hardenedlinux/cheap-pcb/README

## Cheap PCB: Better understanding the current status of hardware supply chain

We did this experimental for fun and profit( better assessment for hardware supply chain security). Read the [full story](https://github.com/hardenedlinux/cheap-pcb/blob/main/cheap-pcb-story.md).
