hardenedlinux/cheap-pcb/stm32-io-extend/v6/gerber/stm32-io-extend-all-pos.png

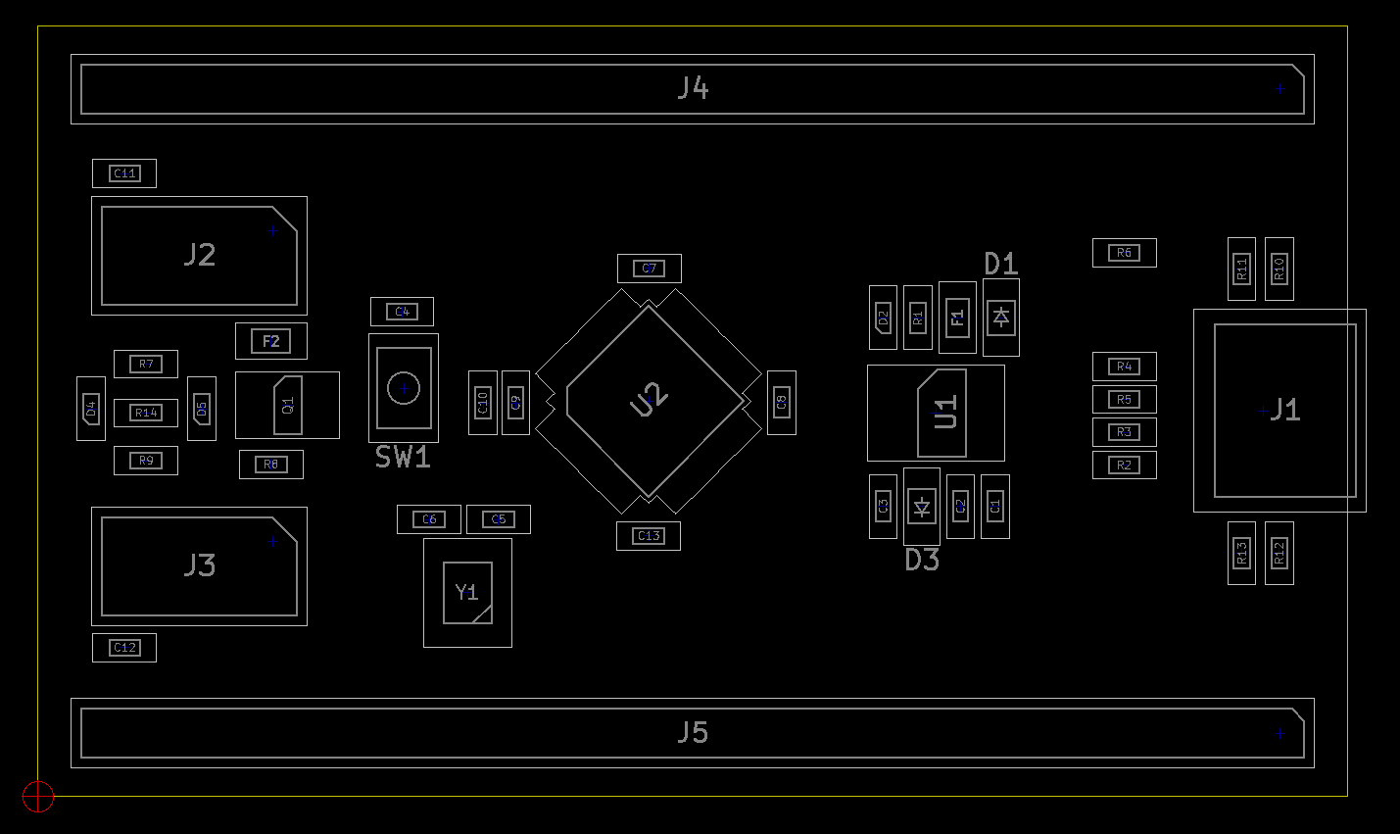
stm32-io-extend/v6/gerber/stm32-io-extend-all-pos.png
