hardenedlinux/cheap-pcb/(threads)

Thread 1 (2021-02-19):

Are these "series capacitors"?

jangid, 2021-02-19:
> For the input and output of the voltage regulator chip, two series capacitors are required to store energy and filter out clutter.

Why are you calling them "series capacitors"? Is this an error or perhaps I have misunderstood something.

cheapcb, 2021-02-19:
Nice catch! Thanks.

Closed 2021-02-19.
