hardenedlinux/cheap-pcb/(list of files, drawings)

Other design files:
stm32-io-extend/v1/stm32-io-extend.dsn
stm32-io-extend/v2/stm32-io-extend.dsn
stm32-io-extend/v3/stm32-io-extend.dsn
stm32-io-extend/v4/stm32-io-extend.dsn
stm32-io-extend/v5/stm32-io-extend.dsn
stm32-io-extend/v6/stm32-io-extend.dsn
