hardenedlinux/cheap-pcb/stm32-io-extend/v4/stm32-io-extend.kicad_pcb

## KiCad design stm32-io-extend/v4/stm32-io-extend.kicad_pcb (2021-02-10, an earlier design)

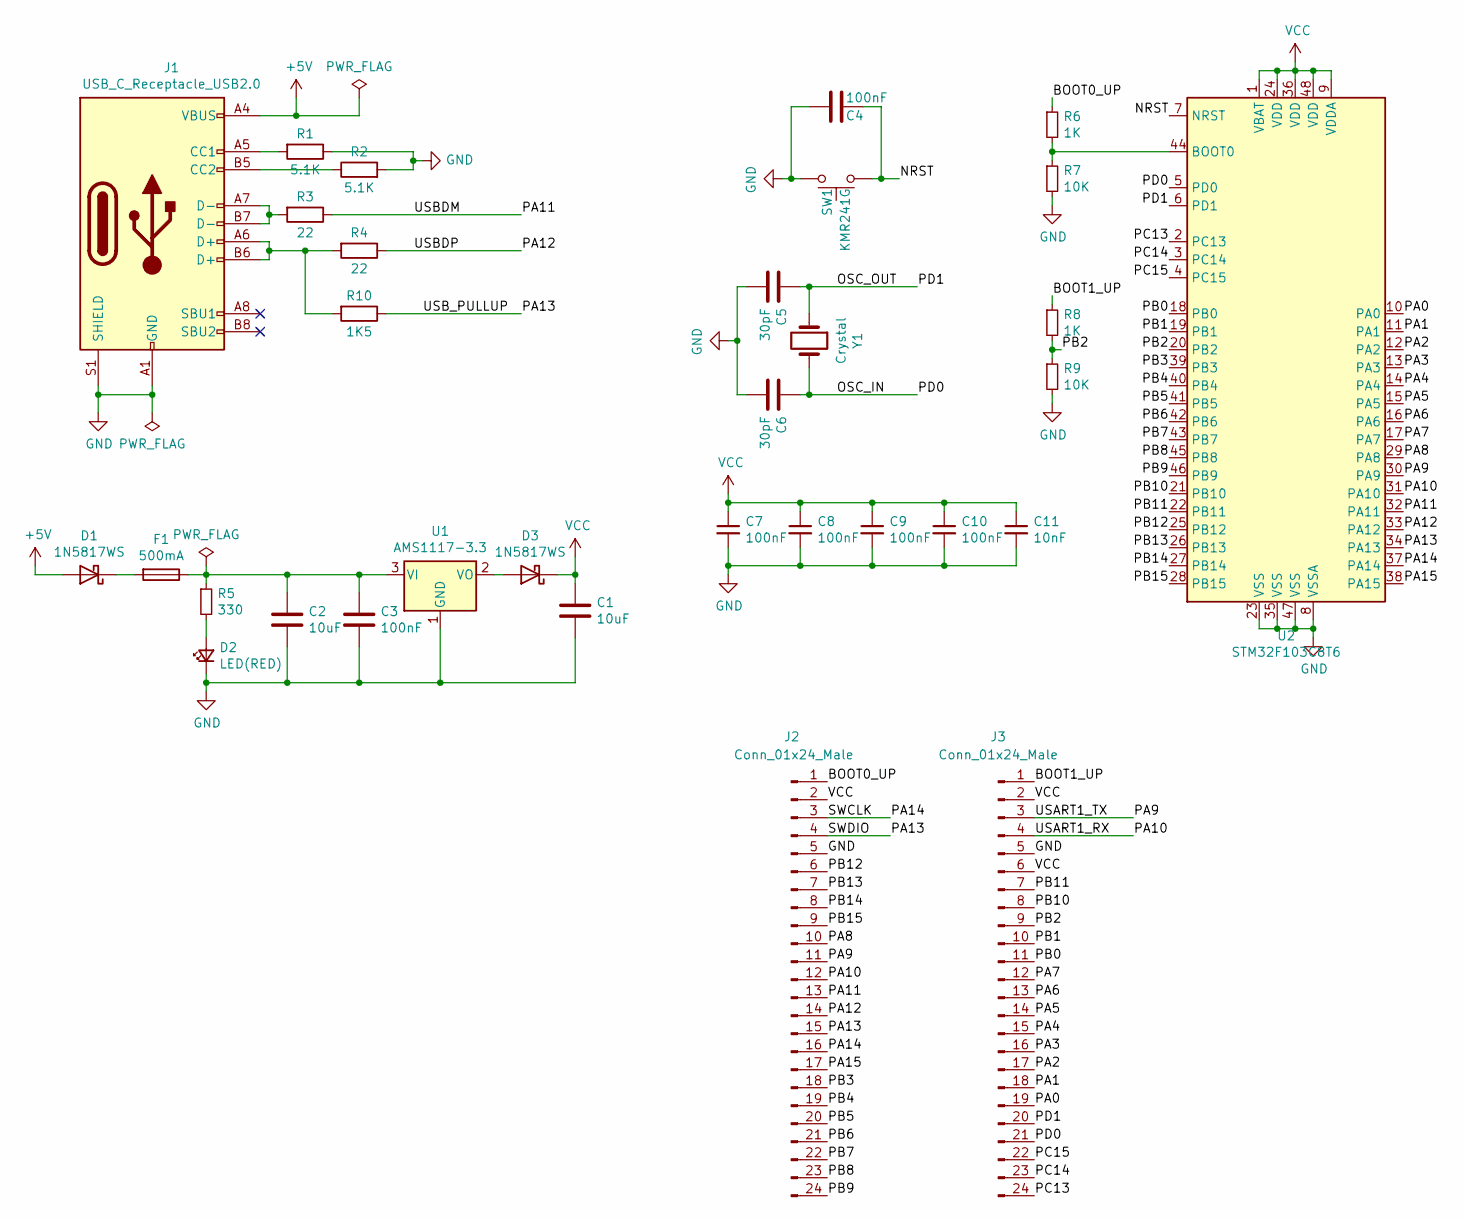
[picture p18: schematic stm32-io-extend.sch]

Parts:
C1, C2: 10uF; C_0603_1608Metric_Pad1.08x0.95mm_HandSolder
C3, C4, C7, C8, C9, C10: 100nF; C_0603_1608Metric_Pad1.08x0.95mm_HandSolder
C5, C6: 30pF; C_0603_1608Metric_Pad1.08x0.95mm_HandSolder
C11: 10nF; C_0603_1608Metric_Pad1.08x0.95mm_HandSolder
D1, D3: 1N5817WS; D_SOD-323_HandSoldering
D2: LED(RED); LED_0603_1608Metric_Pad1.05x0.95mm_HandSolder
F1: 500mA; Fuse_0805_2012Metric_Pad1.15x1.40mm_HandSolder
J1: USB_C_Receptacle_USB2.0; USB_C_Receptacle_Palconn_UTC16-G
J2, J3: Conn_01x24_Male; PinHeader_1x24_P2.54mm_Vertical
R1, R2: 5.1K; R_0603_1608Metric_Pad0.98x0.95mm_HandSolder
R3, R4: 22; R_0603_1608Metric_Pad0.98x0.95mm_HandSolder
R5: 330; R_0603_1608Metric_Pad0.98x0.95mm_HandSolder
R6, R8: 1K; R_0603_1608Metric_Pad0.98x0.95mm_HandSolder
R7, R9: 10K; R_0603_1608Metric_Pad0.98x0.95mm_HandSolder
R10: 1K5; R_0603_1608Metric_Pad0.98x0.95mm_HandSolder
SW1: KMR241G; SW_Push_1P1T-SH_NO_CK_KMR2xxG
U1: AMS1117-3.3; SOT-89-3_Handsoldering
U2: STM32F103C8T6; LQFP-48_7x7mm_P0.5mm
Y1: Crystal; Crystal_SMD_HC49-SD_HandSoldering

Connections:
+5V: D1.2 (A), J1.A4 (VBUS), J1.A9 (VBUS), J1.B4 (VBUS), J1.B9 (VBUS)
/BOOT0_UP: J2.1, R6.1
/BOOT1_UP: J3.1, R8.1
/NRST: C4.1, SW1.1, U2.7 (NRST)
/OSC_IN: C6.1, J3.21, U2.5 (PD0), Y1.2
/OSC_OUT: C5.1, J3.20, U2.6 (PD1), Y1.1
/PA0: J3.19, U2.10 (PA0)
/PA1: J3.18, U2.11 (PA1)
/PA2: J3.17, U2.12 (PA2)
/PA3: J3.16, U2.13 (PA3)
/PA4: J3.15, U2.14 (PA4)
/PA5: J3.14, U2.15 (PA5)
/PA6: J3.13, U2.16 (PA6)
/PA7: J3.12, U2.17 (PA7)
/PA8: J2.10, U2.29 (PA8)
/PA9: J2.11, J3.3, U2.30 (PA9)
/PA10: J2.12, J3.4, U2.31 (PA10)
/PA11: J2.13, R3.1, U2.32 (PA11)
/PA12: J2.14, R4.1, U2.33 (PA12)
/PA13: J2.4, J2.15, R10.1, U2.34 (PA13)
/PA14: J2.3, J2.16, U2.37 (PA14)
/PA15: J2.17, U2.38 (PA15)
/PB0: J3.11, U2.18 (PB0)
/PB1: J3.10, U2.19 (PB1)
/PB2: J3.9, R8.2, R9.1, U2.20 (PB2)
/PB3: J2.18, U2.39 (PB3)
/PB4: J2.19, U2.40 (PB4)
/PB5: J2.20, U2.41 (PB5)
/PB6: J2.21, U2.42 (PB6)
/PB7: J2.22, U2.43 (PB7)
/PB8: J2.23, U2.45 (PB8)
/PB9: J2.24, U2.46 (PB9)
/PB10: J3.8, U2.21 (PB10)
/PB11: J3.7, U2.22 (PB11)
/PB12: J2.6, U2.25 (PB12)
/PB13: J2.7, U2.26 (PB13)
/PB14: J2.8, U2.27 (PB14)
/PB15: J2.9, U2.28 (PB15)
/PC13: J3.24, U2.2 (PC13)
/PC14: J3.23, U2.3 (PC14)
/PC15: J3.22, U2.4 (PC15)
GND: C1.2, C2.2, C3.2, C4.2, C5.2, C6.2, C7.2, C8.2, C9.2, C10.2, C11.2, D2.1 (K), J1.A1 (GND), J1.A12 (GND), J1.B1 (GND), J1.B12 (GND), J1.S1 (SHIELD), J2.5, J3.5, R1.1, R2.2, R7.2, R9.2, SW1.2, U1.1 (GND), U2.8 (VSSA), U2.23 (VSS), U2.35 (VSS), U2.47 (VSS)
unnamed: C2.1, C3.1, F1.1, R5.1, U1.3 (VI)
unnamed: D1.1 (K), F1.2
unnamed: D2.2 (A), R5.2
unnamed: D3.2 (A), U1.2 (VO)
unnamed: J1.A5 (CC1), R1.2
unnamed: J1.A6 (D+), J1.B6 (D+), R4.2, R10.2
unnamed: J1.A7 (D-), J1.B7 (D-), R3.2
unnamed: J1.B5 (CC2), R2.1
unnamed: R6.2, R7.1, U2.44 (BOOT0)
VCC: C1.1, C7.1, C8.1, C9.1, C10.1, C11.1, D3.1 (K), J2.2, J3.2, J3.6, U2.1 (VBAT), U2.9 (VDDA), U2.24 (VDD), U2.36 (VDD), U2.48 (VDD)

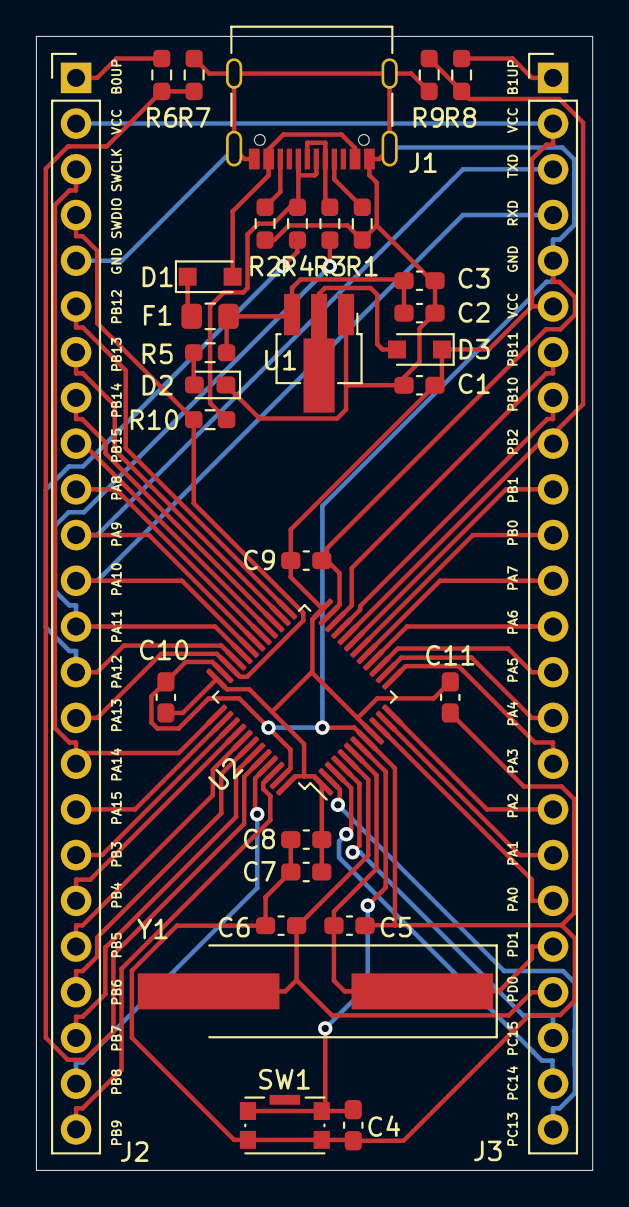
[picture p19: board stm32-io-extend/v4/stm32-io-extend.kicad_pcb from above]

Board: 2 copper layers, 30.9 x 63.0 mm, 32 parts (0 on the bottom side), 52 nets.
