hardenedlinux/cheap-pcb/stm32-io-extend/v1/stm32-io-extend.kicad_pcb

## KiCad design stm32-io-extend/v1/stm32-io-extend.kicad_pcb (2021-02-10, an earlier design)

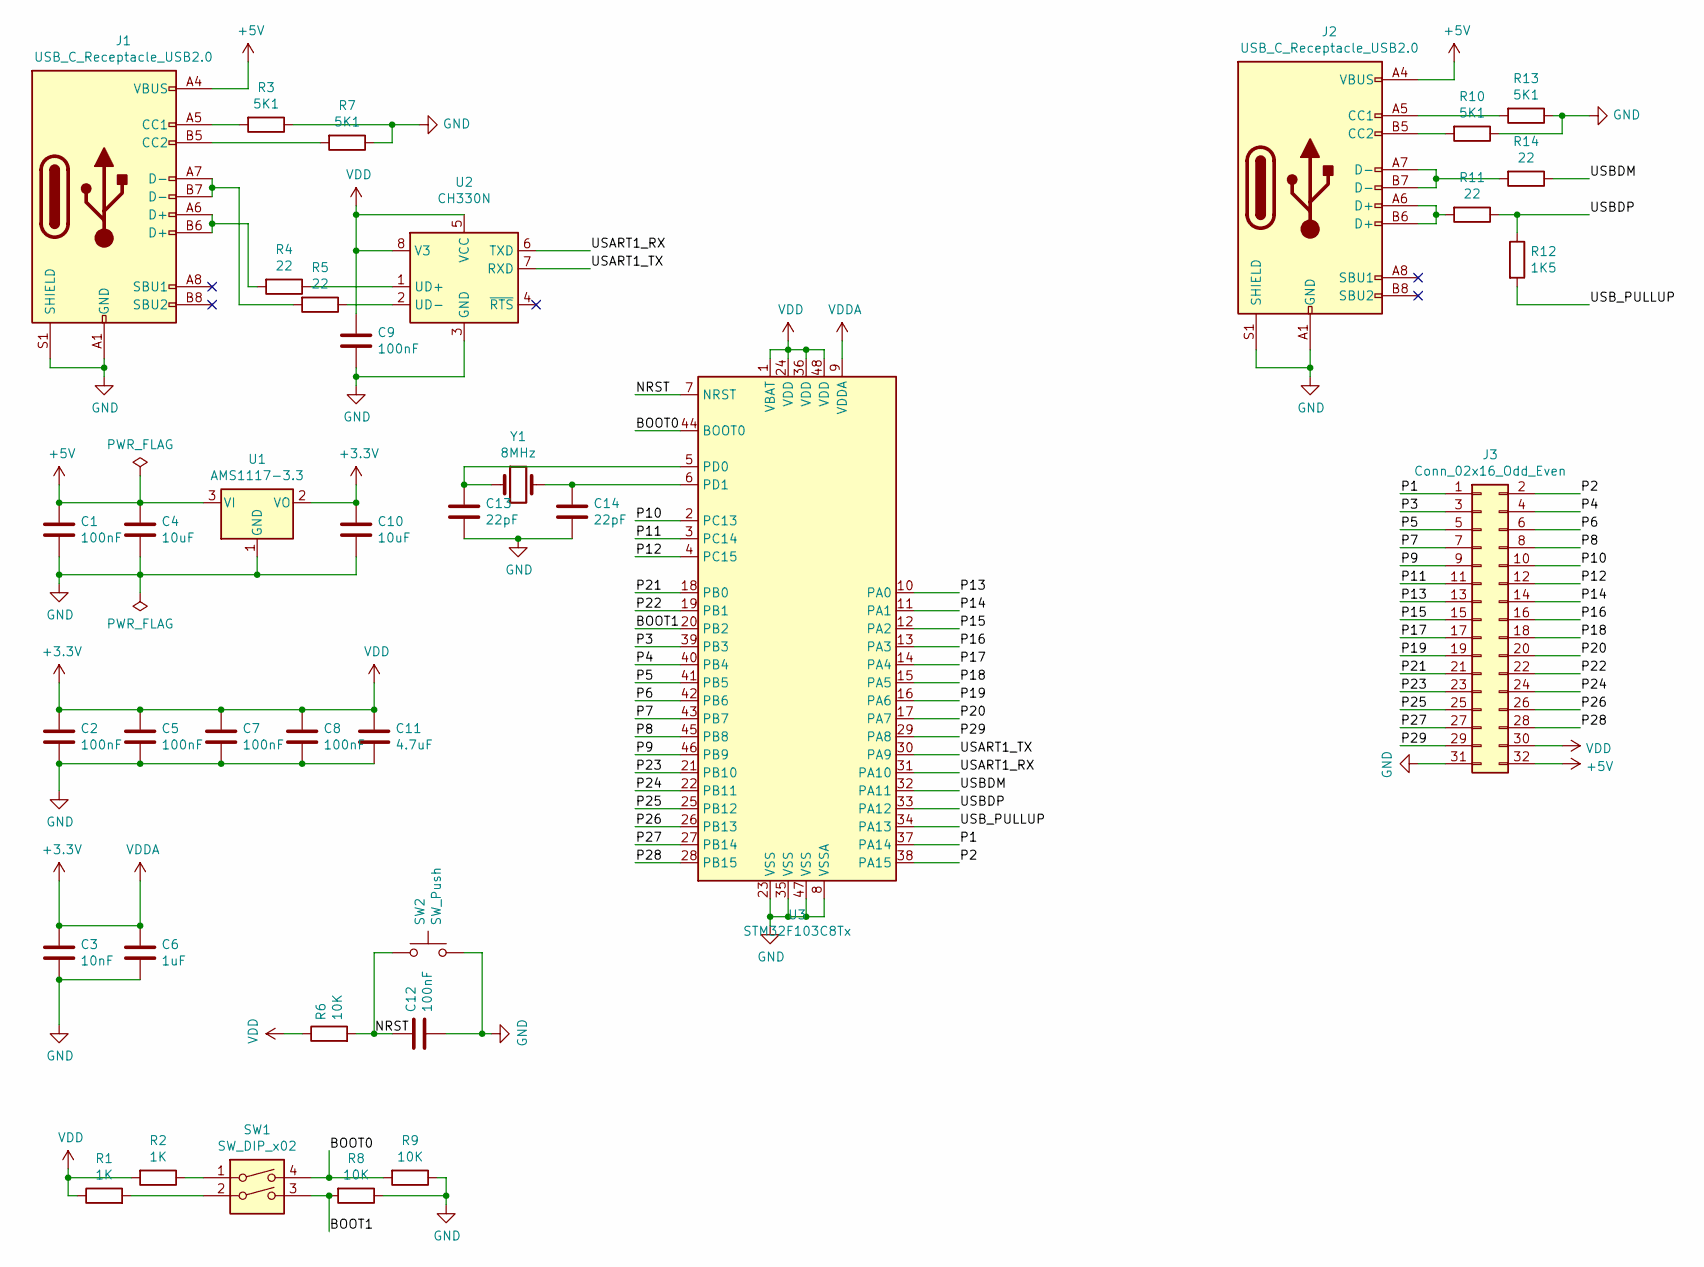
[picture p20: schematic stm32-io-extend.sch]

Parts:
C1, C2, C5, C7, C8, C9, C12: 100nF; C_0201_0603Metric
C3: 10nF; C_0201_0603Metric
C4, C10: 10uF; C_0603_1608Metric
C6: 1uF; C_0201_0603Metric
C11: 4.7uF; C_0603_1608Metric
C13, C14: 22pF; C_0201_0603Metric
J1, J2: USB_C_Receptacle_USB2.0; USB_C_Receptacle_Palconn_UTC16-G
J3: Conn_02x16_Odd_Even; PinSocket_2x16_P2.54mm_Vertical
R1, R2: 1K; R_0201_0603Metric
R3, R7, R10, R13: 5K1; R_0201_0603Metric
R4, R5, R11, R14: 22; R_0201_0603Metric
R6, R8, R9: 10K; R_0201_0603Metric
R12: 1K5; R_0201_0603Metric
SW1: SW_DIP_x02; SW_DIP_SPSTx02_Slide_6.7x6.64mm_W7.62mm_P2.54mm_LowProfile
SW2: SW_Push; SW_PUSH_6mm
U1: AMS1117-3.3; SOT-223
U2: CH330N; SOIC-8_3.9x4.9mm_P1.27mm
U3: STM32F103C8Tx; LQFP-48_7x7mm_P0.5mm
Y1: 8MHz; Crystal_HC49-U_Vertical

Connections:
+3V3: C2.1, C3.1, C5.1, C6.1, C7.1, C8.1, C9.1, C10.1, C11.1, J3.30, R1.1, R2.2, R6.1, U1.2 (VO), U2.5 (VCC), U2.8 (V3), U3.1 (VBAT), U3.9 (VDDA), U3.24 (VDD), U3.36 (VDD), U3.48 (VDD)
+5V: C1.1, C4.1, J1.A4 (VBUS), J1.A9 (VBUS), J1.B4 (VBUS), J1.B9 (VBUS), J2.A4 (VBUS), J2.A9 (VBUS), J2.B4 (VBUS), J2.B9 (VBUS), J3.32, U1.3 (VI)
/BOOT0: R9.2, SW1.4, U3.44 (BOOT0)
/BOOT1: R8.2, SW1.3, U3.20 (PB2)
/NRST: C12.1, R6.2, SW2.1, U3.7 (NRST)
/P1: J3.1, U3.37 (PA14)
/P2: J3.2, U3.38 (PA15)
/P3: J3.3, U3.39 (PB3)
/P4: J3.4, U3.40 (PB4)
/P5: J3.5, U3.41 (PB5)
/P6: J3.6, U3.42 (PB6)
/P7: J3.7, U3.43 (PB7)
/P8: J3.8, U3.45 (PB8)
/P9: J3.9, U3.46 (PB9)
/P10: J3.10, U3.2 (PC13)
/P11: J3.11, U3.3 (PC14)
/P12: J3.12, U3.4 (PC15)
/P13: J3.13, U3.10 (PA0)
/P14: J3.14, U3.11 (PA1)
/P15: J3.15, U3.12 (PA2)
/P16: J3.16, U3.13 (PA3)
/P17: J3.17, U3.14 (PA4)
/P18: J3.18, U3.15 (PA5)
/P19: J3.19, U3.16 (PA6)
/P20: J3.20, U3.17 (PA7)
/P21: J3.21, U3.18 (PB0)
/P22: J3.22, U3.19 (PB1)
/P23: J3.23, U3.21 (PB10)
/P24: J3.24, U3.22 (PB11)
/P25: J3.25, U3.25 (PB12)
/P26: J3.26, U3.26 (PB13)
/P27: J3.27, U3.27 (PB14)
/P28: J3.28, U3.28 (PB15)
/P29: J3.29, U3.29 (PA8)
/USART1_RX: U2.6 (TXD), U3.31 (PA10)
/USART1_TX: U2.7 (RXD), U3.30 (PA9)
/USBDM: R14.1, U3.32 (PA11)
/USBDP: R11.1, R12.1, U3.33 (PA12)
/USB_PULLUP: R12.2, U3.34 (PA13)
GND: C1.2, C2.2, C3.2, C4.2, C5.2, C6.2, C7.2, C8.2, C9.2, C10.2, C11.2, C12.2, C13.2, C14.2, J1.A1 (GND), J1.A12 (GND), J1.B1 (GND), J1.B12 (GND), J1.S1 (SHIELD), J2.A1 (GND), J2.A12 (GND), J2.B1 (GND), J2.B12 (GND), J2.S1 (SHIELD), J3.31, R3.1, R7.1, R8.1, R9.1, R10.1, R13.1, SW2.2, U1.1 (GND), U2.3 (GND), U3.8 (VSSA), U3.23 (VSS), U3.35 (VSS), U3.47 (VSS)
unnamed: C13.1, U3.5 (PD0), Y1.1
unnamed: C14.1, U3.6 (PD1), Y1.2
unnamed: J1.A5 (CC1), R3.2
unnamed: J1.A6 (D+), J1.B6 (D+), R4.2
unnamed: J1.A7 (D-), J1.B7 (D-), R5.2
unnamed: J1.B5 (CC2), R7.2
unnamed: J2.A5 (CC1), R13.2
unnamed: J2.A6 (D+), J2.B6 (D+), R11.2
unnamed: J2.A7 (D-), J2.B7 (D-), R14.2
unnamed: J2.B5 (CC2), R10.2
unnamed: R1.2, SW1.2
unnamed: R2.1, SW1.1
unnamed: R4.1, U2.1 (UD+)
unnamed: R5.1, U2.2 (UD-)

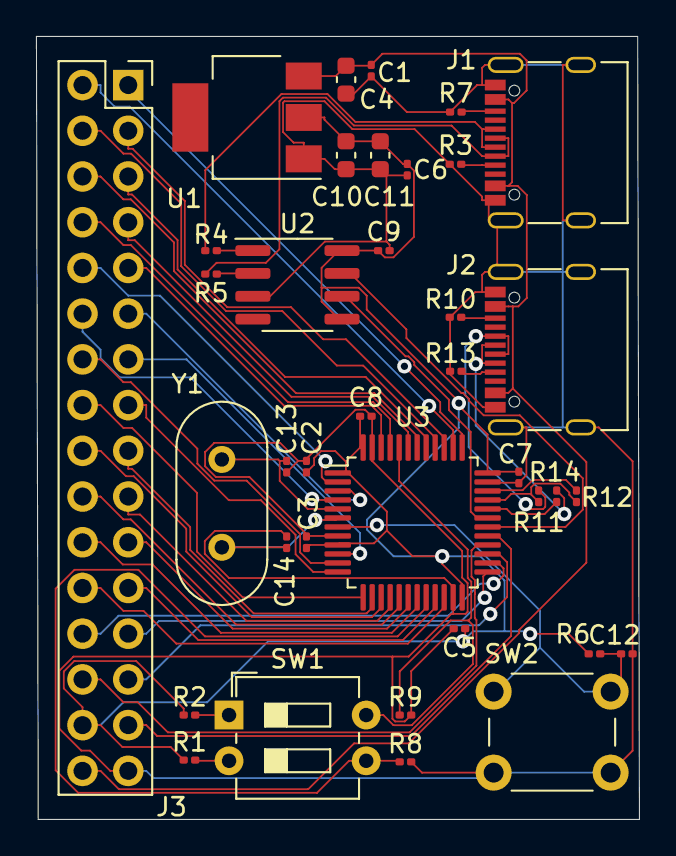
[picture p21: board stm32-io-extend/v1/stm32-io-extend.kicad_pcb from above]

Board: 2 copper layers, 33.5 x 43.5 mm, 37 parts (0 on the bottom side), 54 nets.
