hardenedlinux/cheap-pcb/stm32-io-extend/v5/stm32-io-extend.kicad_pcb

## KiCad design stm32-io-extend/v5/stm32-io-extend.kicad_pcb (2021-02-10, an earlier design)

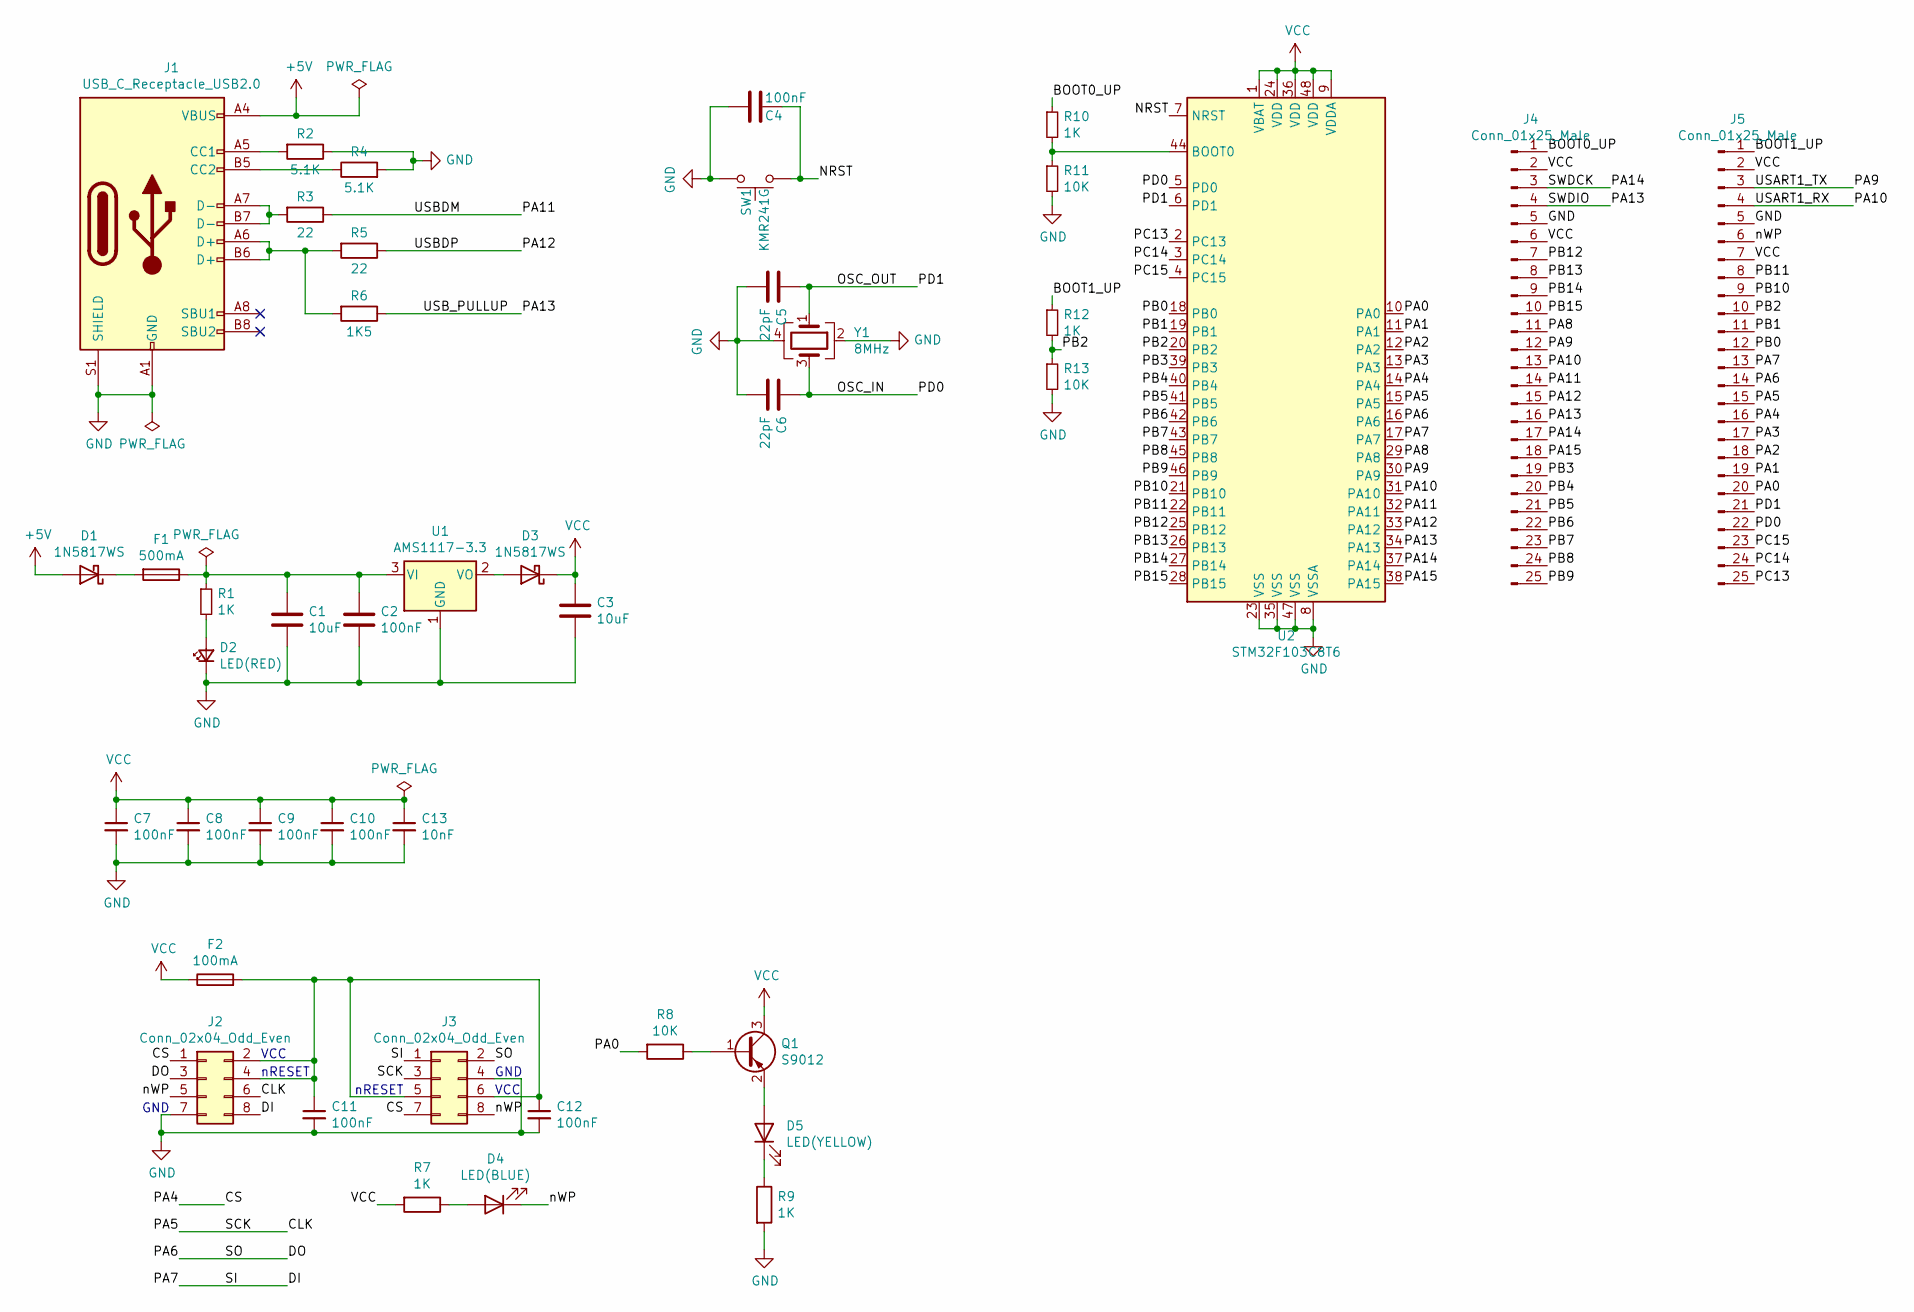
[picture p22: schematic stm32-io-extend.sch]

Parts:
C1, C3: 10uF; C_0603_1608Metric_Pad1.08x0.95mm_HandSolder
C2, C4, C7, C8, C9, C10, C11, C12: 100nF; C_0603_1608Metric_Pad1.08x0.95mm_HandSolder
C5, C6: 22pF; C_0603_1608Metric_Pad1.08x0.95mm_HandSolder
C13: 10nF; C_0603_1608Metric_Pad1.08x0.95mm_HandSolder
D1, D3: 1N5817WS; D_SOD-323_HandSoldering
D2: LED(RED); LED_0603_1608Metric_Pad1.05x0.95mm_HandSolder
D4: LED(BLUE); LED_0603_1608Metric_Pad1.05x0.95mm_HandSolder
D5: LED(YELLOW); LED_0603_1608Metric_Pad1.05x0.95mm_HandSolder
F1: 500mA; Fuse_0805_2012Metric_Pad1.15x1.40mm_HandSolder
F2: 100mA; Fuse_0805_2012Metric_Pad1.15x1.40mm_HandSolder
J1: USB_C_Receptacle_USB2.0; USB_C_Receptacle_Palconn_UTC16-G
J2, J3: Conn_02x04_Odd_Even; PinHeader_2x04_P2.54mm_Vertical
J4, J5: Conn_01x25_Male; PinHeader_1x25_P2.54mm_Vertical
Q1: S9012; SOT-23_Handsoldering
R1, R7, R9, R10, R12: 1K; R_0603_1608Metric_Pad0.98x0.95mm_HandSolder
R2, R4: 5.1K; R_0603_1608Metric_Pad0.98x0.95mm_HandSolder
R3, R5: 22; R_0603_1608Metric_Pad0.98x0.95mm_HandSolder
R6: 1K5; R_0603_1608Metric_Pad0.98x0.95mm_HandSolder
R8, R11, R13: 10K; R_0603_1608Metric_Pad0.98x0.95mm_HandSolder
SW1: KMR241G; SW_Push_1P1T-SH_NO_CK_KMR2xxG
U1: AMS1117-3.3; SOT-89-3_Handsoldering
U2: STM32F103C8T6; LQFP-48_7x7mm_P0.5mm
Y1: 8MHz; Crystal_SMD_3225-4Pin_3.2x2.5mm_HandSoldering

Connections:
+5V: D1.2 (A), J1.A4 (VBUS), J1.A9 (VBUS), J1.B4 (VBUS), J1.B9 (VBUS)
/BOOT0_UP: J4.1, R10.1
/BOOT1_UP: J5.1, R12.1
/CLK: J2.6, J3.3, J5.15, U2.15 (PA5)
/CS: J2.1, J3.7, J5.16, U2.14 (PA4)
/DI: J2.8, J3.1, J5.13, U2.17 (PA7)
/DO: J2.3, J3.2, J5.14, U2.16 (PA6)
/NRST: C4.1, SW1.1, U2.7 (NRST)
/OSC_IN: C6.1, J5.22, U2.5 (PD0), Y1.3
/OSC_OUT: C5.1, J5.21, U2.6 (PD1), Y1.1
/PA0: J5.20, R8.2, U2.10 (PA0)
/PA1: J5.19, U2.11 (PA1)
/PA2: J5.18, U2.12 (PA2)
/PA3: J5.17, U2.13 (PA3)
/PA8: J4.11, U2.29 (PA8)
/PA9: J4.12, J5.3, U2.30 (PA9)
/PA10: J4.13, J5.4, U2.31 (PA10)
/PA11: J4.14, R3.1, U2.32 (PA11)
/PA12: J4.15, R5.1, U2.33 (PA12)
/PA13: J4.4, J4.16, R6.1, U2.34 (PA13)
/PA14: J4.3, J4.17, U2.37 (PA14)
/PA15: J4.18, U2.38 (PA15)
/PB0: J5.12, U2.18 (PB0)
/PB1: J5.11, U2.19 (PB1)
/PB2: J5.10, R12.2, R13.1, U2.20 (PB2)
/PB3: J4.19, U2.39 (PB3)
/PB4: J4.20, U2.40 (PB4)
/PB5: J4.21, U2.41 (PB5)
/PB6: J4.22, U2.42 (PB6)
/PB7: J4.23, U2.43 (PB7)
/PB8: J4.24, U2.45 (PB8)
/PB9: J4.25, U2.46 (PB9)
/PB10: J5.9, U2.21 (PB10)
/PB11: J5.8, U2.22 (PB11)
/PB12: J4.7, U2.25 (PB12)
/PB13: J4.8, U2.26 (PB13)
/PB14: J4.9, U2.27 (PB14)
/PB15: J4.10, U2.28 (PB15)
/PC13: J5.25, U2.2 (PC13)
/PC14: J5.24, U2.3 (PC14)
/PC15: J5.23, U2.4 (PC15)
/nWP: D4.1 (K), J2.5, J3.8, J5.6
GND: C1.2, C2.2, C3.2, C4.2, C5.2, C6.2, C7.2, C8.2, C9.2, C10.2, C11.2, C12.2, C13.2, D2.1 (K), J1.A1 (GND), J1.A12 (GND), J1.B1 (GND), J1.B12 (GND), J1.S1 (SHIELD), J2.7, J3.4, J4.5, J5.5, R2.1, R4.2, R9.2, R11.2, R13.2, SW1.2, U1.1 (GND), U2.8 (VSSA), U2.23 (VSS), U2.35 (VSS), U2.47 (VSS), Y1.2, Y1.4
unnamed: C1.1, C2.1, F1.1, R1.1, U1.3 (VI)
unnamed: C11.1, C12.1, F2.2, J2.2, J2.4, J3.5, J3.6
unnamed: D1.1 (K), F1.2
unnamed: D2.2 (A), R1.2
unnamed: D3.2 (A), U1.2 (VO)
unnamed: D4.2 (A), R7.1
unnamed: D5.1 (K), R9.1
unnamed: D5.2 (A), Q1.2 (E)
unnamed: J1.A5 (CC1), R2.2
unnamed: J1.A6 (D+), J1.B6 (D+), R5.2, R6.2
unnamed: J1.A7 (D-), J1.B7 (D-), R3.2
unnamed: J1.B5 (CC2), R4.1
unnamed: Q1.1 (B), R8.1
unnamed: R10.2, R11.1, U2.44 (BOOT0)
VCC: C3.1, C7.1, C8.1, C9.1, C10.1, C13.1, D3.1 (K), F2.1, J4.2, J4.6, J5.2, J5.7, Q1.3 (C), R7.2, U2.1 (VBAT), U2.9 (VDDA), U2.24 (VDD), U2.36 (VDD), U2.48 (VDD)

Notes on the sheet:
VCC
nRESET
GND

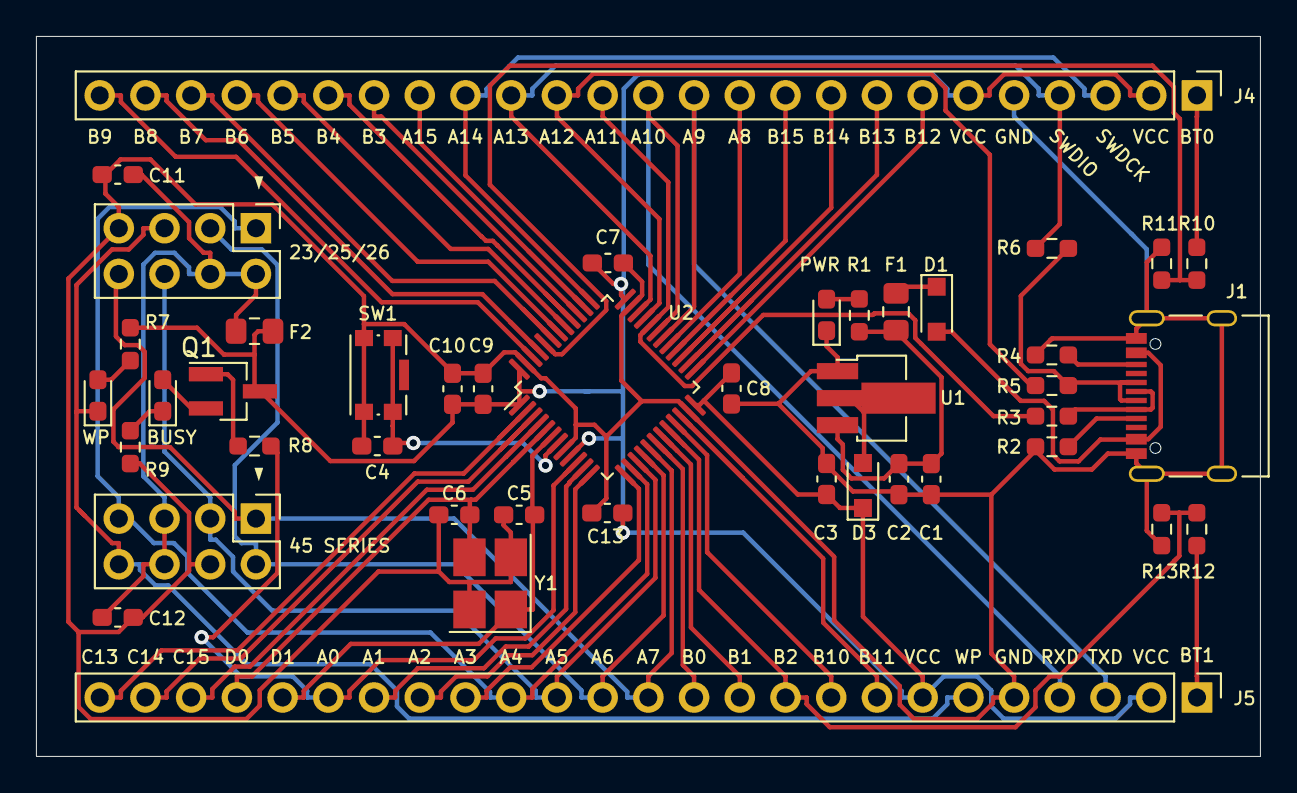
[picture p23: board stm32-io-extend/v5/stm32-io-extend.kicad_pcb from above]

Board: 2 copper layers, 68.0 x 40.0 mm, 43 parts (0 on the bottom side), 58 nets.
