hardenedlinux/cheap-pcb/stm32-io-extend/v3/stm32-io-extend.kicad_pcb

## KiCad design stm32-io-extend/v3/stm32-io-extend.kicad_pcb (2021-02-10, an earlier design)

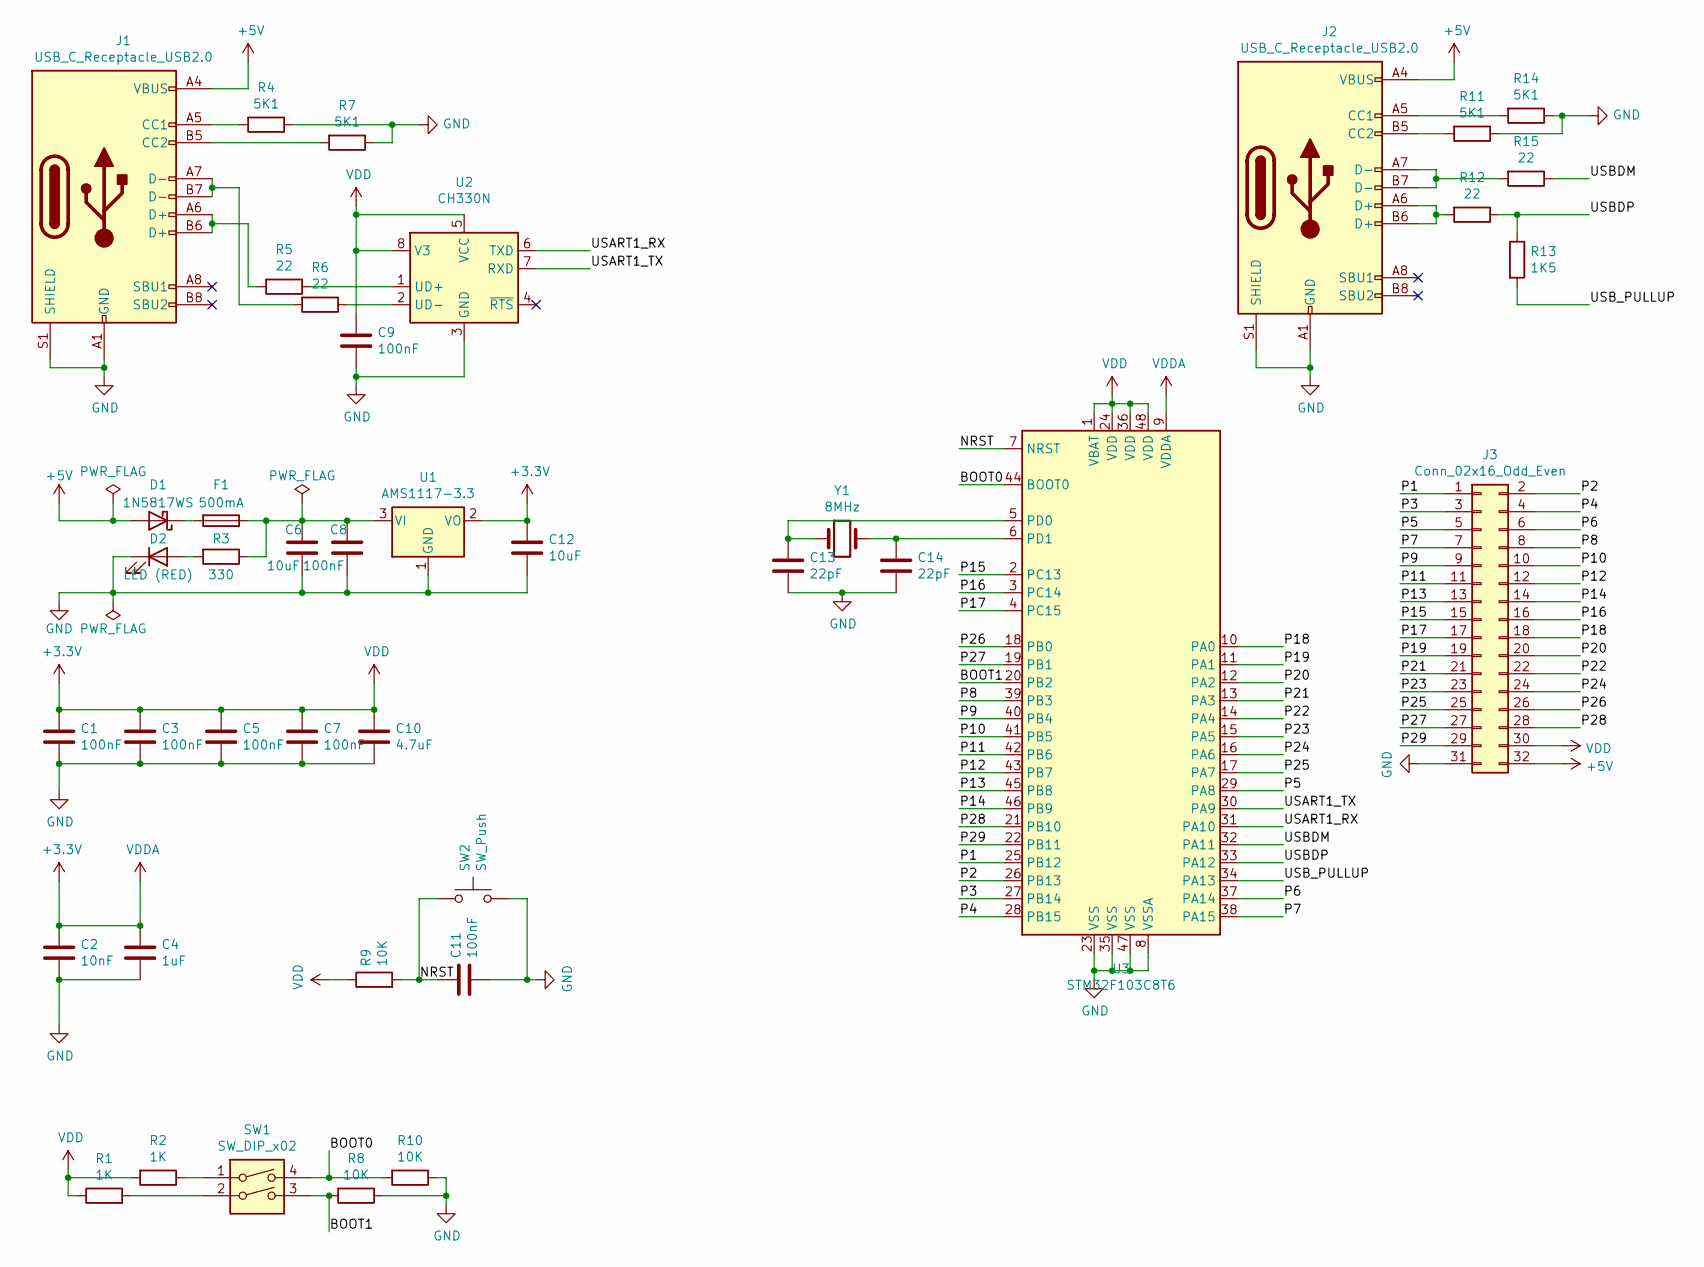
[picture p24: schematic stm32-io-extend.sch]

Parts:
C1, C3, C5, C7, C8, C9, C11: 100nF; C_0603_1608Metric
C2: 10nF; C_0603_1608Metric
C4: 1uF; C_0603_1608Metric
C6, C12: 10uF; C_0603_1608Metric
C10: 4.7uF; C_0603_1608Metric
C13, C14: 22pF; C_0603_1608Metric
D1: 1N5817WS; D_SOD-323
D2: LED (RED); LED_0603_1608Metric
F1: 500mA; Fuse_0805_2012Metric
J1, J2: USB_C_Receptacle_USB2.0; USB_C_Receptacle_Palconn_UTC16-G
J3: Conn_02x16_Odd_Even; PinSocket_2x16_P2.54mm_Vertical
R1, R2: 1K; R_0603_1608Metric
R3: 330; R_0603_1608Metric
R4, R7, R11, R14: 5K1; R_0603_1608Metric
R5, R6, R12, R15: 22; R_0603_1608Metric
R8, R9, R10: 10K; R_0603_1608Metric
R13: 1K5; R_0603_1608Metric
SW1: SW_DIP_x02; SW_DIP_SPSTx02_Slide_6.7x6.64mm_W7.62mm_P2.54mm_LowProfile
SW2: SW_Push; SW_PUSH_6mm
U1: AMS1117-3.3; SOT-89-3
U2: CH330N; SOIC-8_3.9x4.9mm_P1.27mm
U3: STM32F103C8T6; LQFP-48_7x7mm_P0.5mm
Y1: 8MHz; Crystal_HC49-U_Vertical

Connections:
+3V3: C1.1, C2.1, C3.1, C4.1, C5.1, C7.1, C9.1, C10.1, C12.1, J3.30, R1.1, R2.2, R9.1, U1.2 (VO), U2.5 (VCC), U2.8 (V3), U3.1 (VBAT), U3.9 (VDDA), U3.24 (VDD), U3.36 (VDD), U3.48 (VDD)
+5V: D1.2 (A), J1.A4 (VBUS), J1.A9 (VBUS), J1.B4 (VBUS), J1.B9 (VBUS), J2.A4 (VBUS), J2.A9 (VBUS), J2.B4 (VBUS), J2.B9 (VBUS), J3.32
/BOOT0: R10.2, SW1.4, U3.44 (BOOT0)
/BOOT1: R8.2, SW1.3, U3.20 (PB2)
/NRST: C11.1, R9.2, SW2.1, U3.7 (NRST)
/P1: J3.1, U3.25 (PB12)
/P2: J3.2, U3.26 (PB13)
/P3: J3.3, U3.27 (PB14)
/P4: J3.4, U3.28 (PB15)
/P5: J3.5, U3.29 (PA8)
/P6: J3.6, U3.37 (PA14)
/P7: J3.7, U3.38 (PA15)
/P8: J3.8, U3.39 (PB3)
/P9: J3.9, U3.40 (PB4)
/P10: J3.10, U3.41 (PB5)
/P11: J3.11, U3.42 (PB6)
/P12: J3.12, U3.43 (PB7)
/P13: J3.13, U3.45 (PB8)
/P14: J3.14, U3.46 (PB9)
/P15: J3.15, U3.2 (PC13)
/P16: J3.16, U3.3 (PC14)
/P17: J3.17, U3.4 (PC15)
/P18: J3.18, U3.10 (PA0)
/P19: J3.19, U3.11 (PA1)
/P20: J3.20, U3.12 (PA2)
/P21: J3.21, U3.13 (PA3)
/P22: J3.22, U3.14 (PA4)
/P23: J3.23, U3.15 (PA5)
/P24: J3.24, U3.16 (PA6)
/P25: J3.25, U3.17 (PA7)
/P26: J3.26, U3.18 (PB0)
/P27: J3.27, U3.19 (PB1)
/P28: J3.28, U3.21 (PB10)
/P29: J3.29, U3.22 (PB11)
/USART1_RX: U2.6 (TXD), U3.31 (PA10)
/USART1_TX: U2.7 (RXD), U3.30 (PA9)
/USBDM: R15.1, U3.32 (PA11)
/USBDP: R12.1, R13.1, U3.33 (PA12)
/USB_PULLUP: R13.2, U3.34 (PA13)
GND: C1.2, C2.2, C3.2, C4.2, C5.2, C6.2, C7.2, C8.2, C9.2, C10.2, C11.2, C12.2, C13.2, C14.2, D2.1 (K), J1.A1 (GND), J1.A12 (GND), J1.B1 (GND), J1.B12 (GND), J1.S1 (SHIELD), J2.A1 (GND), J2.A12 (GND), J2.B1 (GND), J2.B12 (GND), J2.S1 (SHIELD), J3.31, R4.1, R7.1, R8.1, R10.1, R11.1, R14.1, SW2.2, U1.1 (GND), U2.3 (GND), U3.8 (VSSA), U3.23 (VSS), U3.35 (VSS), U3.47 (VSS)
unnamed: C6.1, C8.1, F1.1, R3.1, U1.3 (VI)
unnamed: C13.1, U3.5 (PD0), Y1.1
unnamed: C14.1, U3.6 (PD1), Y1.2
unnamed: D1.1 (K), F1.2
unnamed: D2.2 (A), R3.2
unnamed: J1.A5 (CC1), R4.2
unnamed: J1.A6 (D+), J1.B6 (D+), R5.2
unnamed: J1.A7 (D-), J1.B7 (D-), R6.2
unnamed: J1.B5 (CC2), R7.2
unnamed: J2.A5 (CC1), R14.2
unnamed: J2.A6 (D+), J2.B6 (D+), R12.2
unnamed: J2.A7 (D-), J2.B7 (D-), R15.2
unnamed: J2.B5 (CC2), R11.2
unnamed: R1.2, SW1.2
unnamed: R2.1, SW1.1
unnamed: R5.1, U2.1 (UD+)
unnamed: R6.1, U2.2 (UD-)

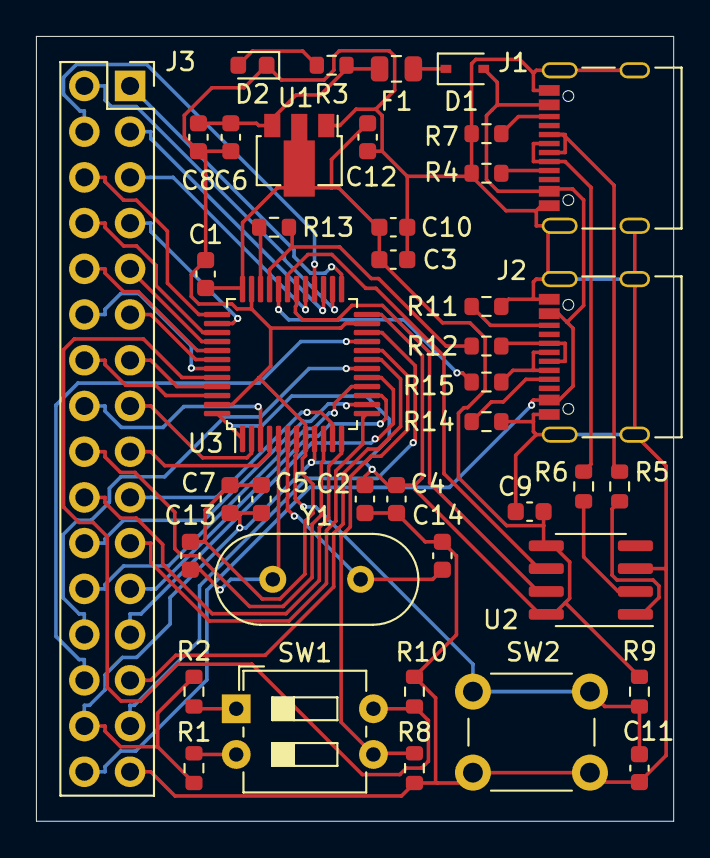
[picture p25: board stm32-io-extend/v3/stm32-io-extend.kicad_pcb from above]

Board: 2 copper layers, 35.4 x 43.6 mm, 41 parts (0 on the bottom side), 57 nets.
